MarkWendler/X2C_BLDC_Shield/README.md

# X2C_BLDC_Shield
BLDC motor driver expansion board for X2C+ development board
