MarkWendler/X2C_BLDC_Shield/BLDC_Schematics.pdf

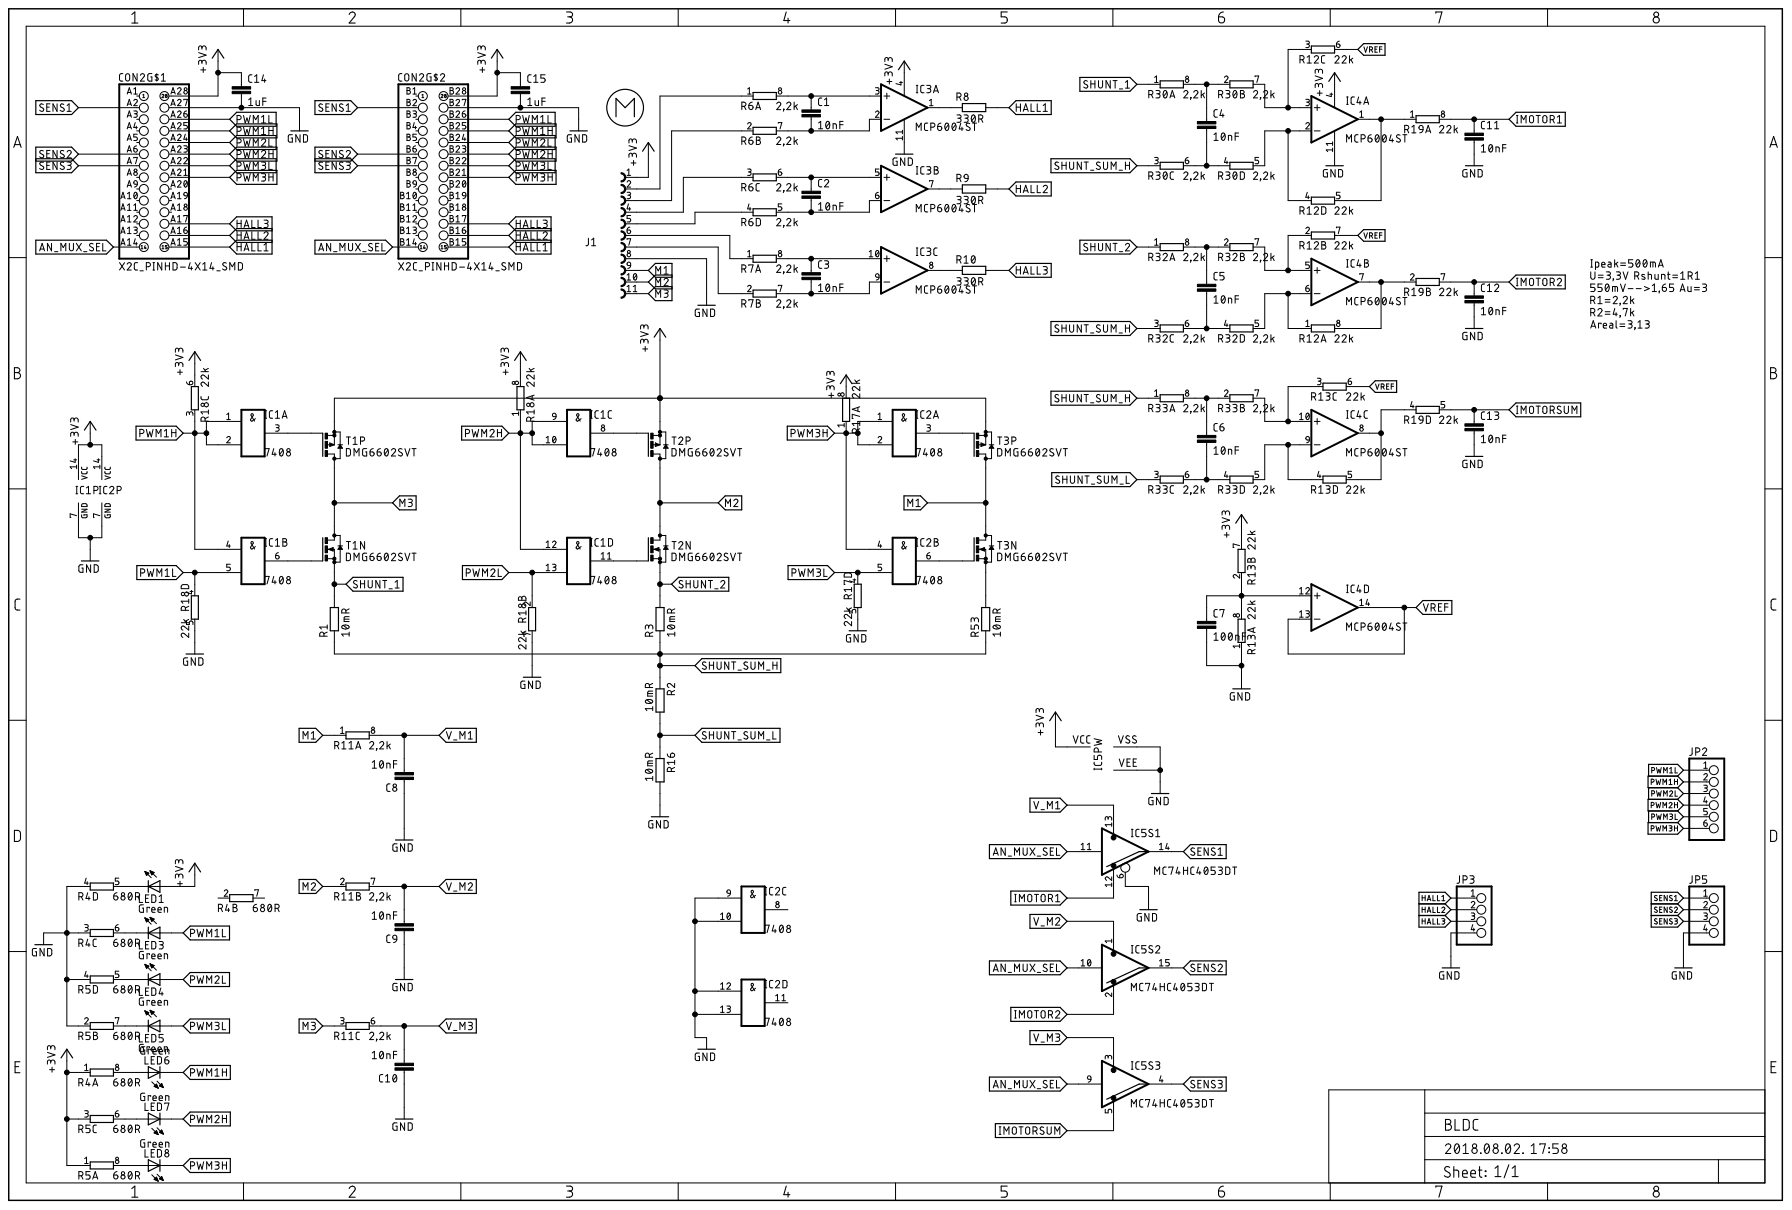
[picture p1: page 1]
