MarkWendler/X2C_BLDC_Shield/BLDC.brd

## EAGLE design BLDC.brd (2018-08-02)

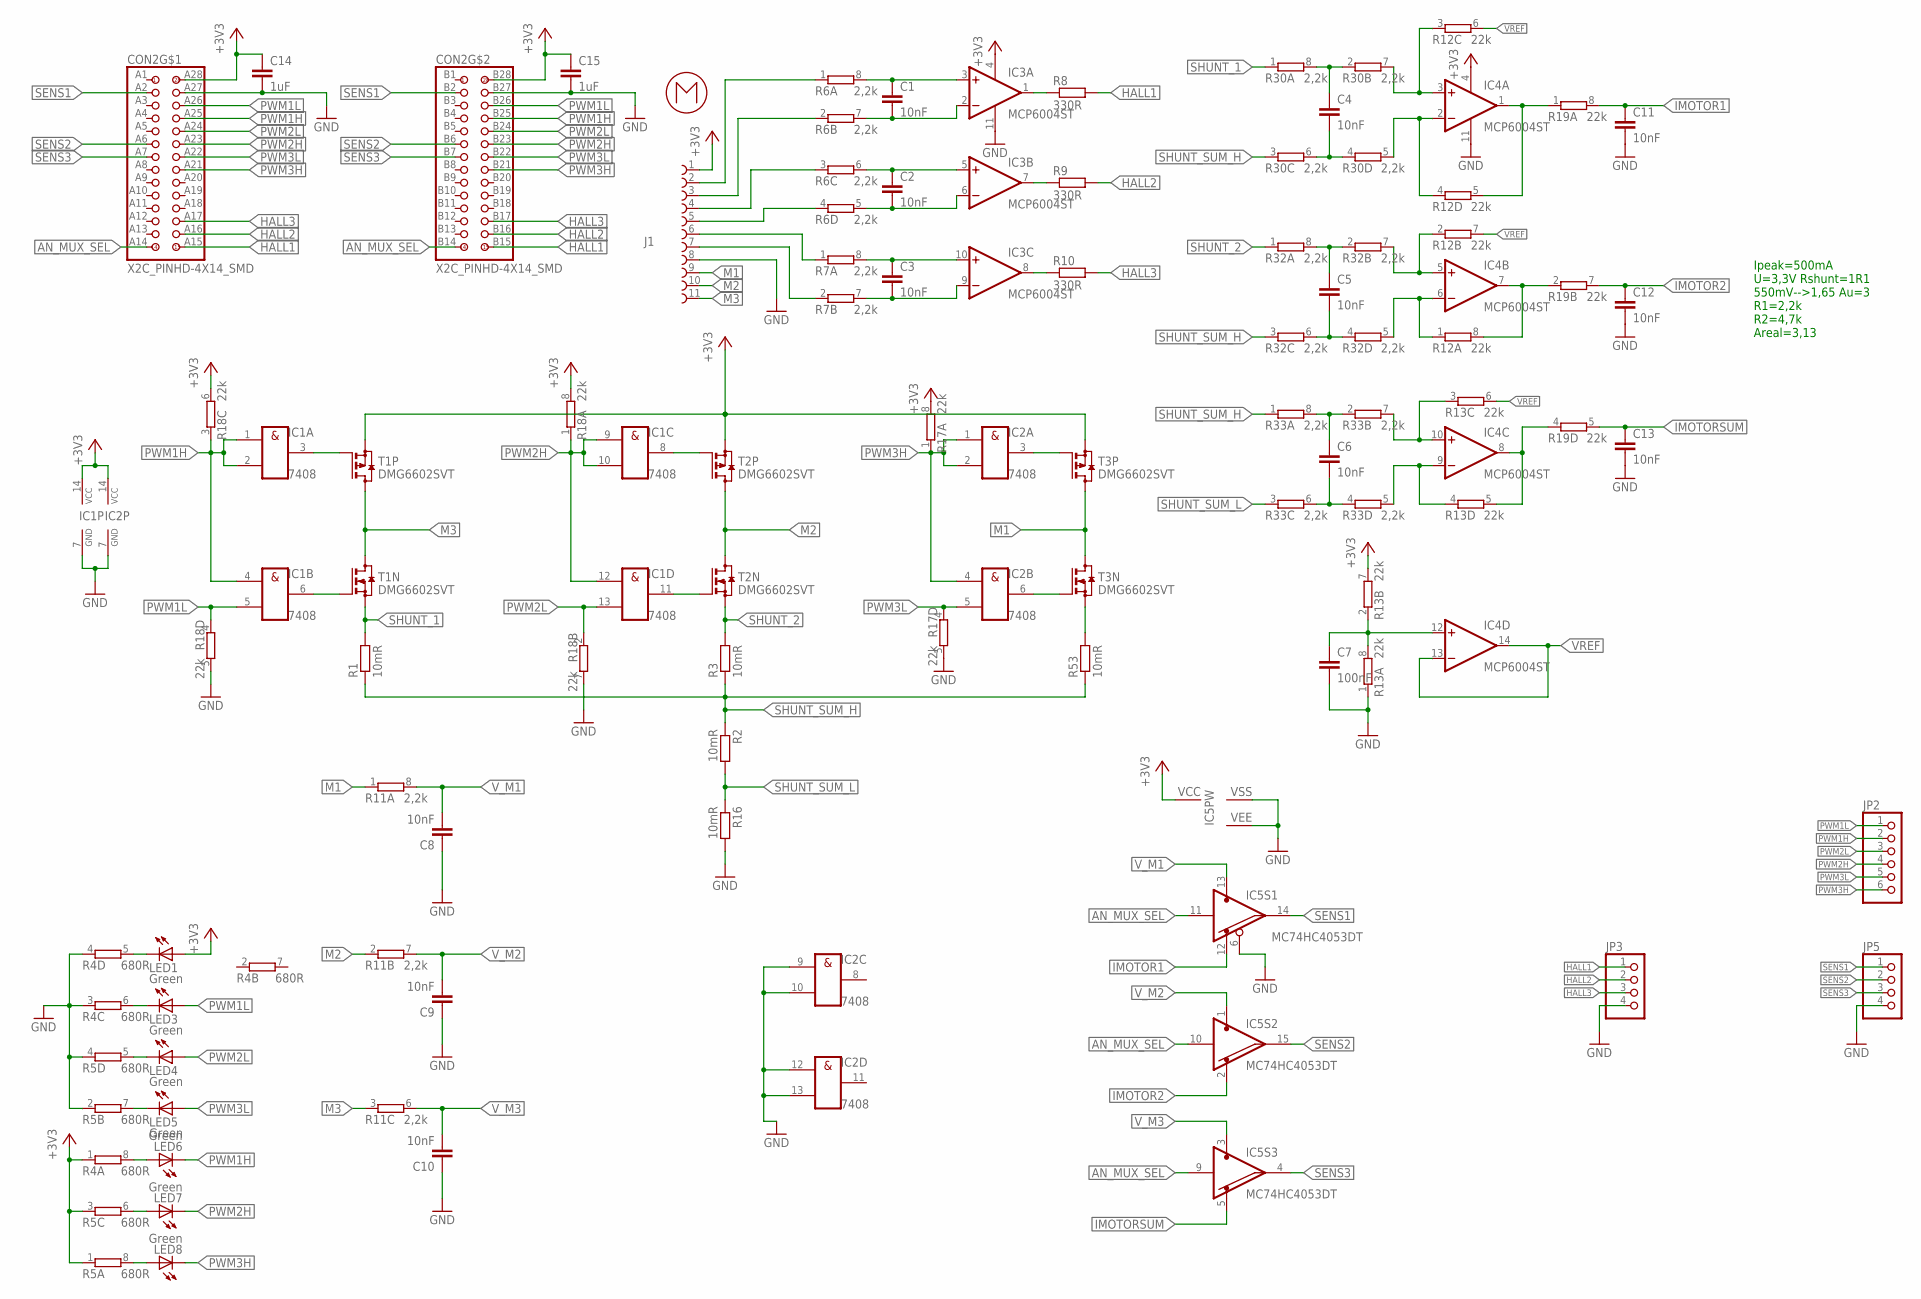
[picture p2: schematic BLDC.sch]

Parts:
C1, C2, C3, C4, C5, C6, C8, C9, C10, C11, C12, C13: 10nF; C0603K
C7: 100nF; C0603K
C14, C15: 1uF; C0603K
CON2: X2C_PINHD-4X14_SMD; X2C_4X14_SMD
IC1, IC2: 7408; TSSOP14
IC3, IC4: MCP6004ST; TSSOP14
IC5: MC74HC4053DT; TSSOP16
J1: 68611114122
JP2: PINHD-1X6; 1X06
JP3, JP5: PINHD-1X4; 1X04
LED1, LED3, LED4, LED5, LED6, LED7, LED8: Green; CHIPLED_0805
R1, R2, R3, R16, R53: 10mR; R1206
R4, R5: 680R; EXBV8V_A
R6, R7, R11, R30, R32, R33: 2,2k; EXBV8V_A
R8, R9, R10: 330R; R0603
R12, R13, R17, R18, R19: 22k; EXBV8V_A
T1, T2, T3: DMG6602SVT; TSOT23-6
U$2: BLDC_MOTOR

Connections:
+3V3: C14.1, C15.1, CON2.A28, CON2.B28 (A28), IC1.14 (VCC), IC2.14 (VCC), IC3.4 (V+), IC4.4 (V+), IC5.16 (VCC), J1.1, LED1.A, R4.1, R5.1, R5.3 (1), R13.7 (2), R17.8 (2), R18.6 (2), R18.8 (2), T1.2 (S), T2.2 (S), T3.2 (S)
AN_MUX_SEL: CON2.A14, CON2.B14 (A14), IC5.9 (I), IC5.10 (I), IC5.11 (I)
GND: C7.2, C8.1, C9.1, C10.1, C11.2, C12.2, C13.2, C14.2, C15.2, CON2.A27, CON2.B27 (A27), IC1.7 (GND), IC2.7 (GND), IC2.9 (I0), IC2.10 (I1), IC2.12 (I0), IC2.13 (I1), IC3.11 (V-), IC4.11 (V-), IC5.6, IC5.7 (VEE), IC5.8 (GND), J1.8, JP3.4, JP5.4, R4.3 (1), R4.4 (1), R5.2 (1), R5.4 (1), R13.1, R16.2, R17.5 (2), R18.5 (2), R18.7 (2)
HALL1: CON2.A15, CON2.B15 (A15), JP3.1, R8.2
HALL2: CON2.A16, CON2.B16 (A16), JP3.2, R9.2
HALL3: CON2.A17, CON2.B17 (A17), JP3.3, R10.2
IMOTOR1: C11.1, IC5.12 (O2), R19.8 (2)
IMOTOR2: C12.1, IC5.2 (O2), R19.7 (2)
IMOTORSUM: C13.1, IC5.5 (O2), R19.5 (2)
M1: J1.9, R11.1, T3.4 (D), T3.6 (D)
M2: J1.10, R11.2 (1), T2.4 (D), T2.6 (D)
M3: J1.11, R11.3 (1), T1.4 (D), T1.6 (D)
unnamed: IC1.3 (O), T1.3 (G)
unnamed: IC1.6 (O), T1.1 (G)
unnamed: IC1.8 (O), T2.3 (G)
unnamed: IC1.11 (O), T2.1 (G)
unnamed: IC2.3 (O), T3.3 (G)
unnamed: IC2.6 (O), T3.1 (G)
unnamed: C1.1, IC3.3 (+IN), R6.8 (2)
unnamed: C1.2, IC3.2 (-IN), R6.7 (2)
unnamed: IC4.8 (OUT), R13.5 (2), R19.4 (1)
unnamed: C5.1, R32.2 (1), R32.8 (2)
unnamed: C4.1, R30.2 (1), R30.8 (2)
unnamed: C4.2, R30.4 (1), R30.6 (2)
unnamed: IC4.3 (+IN), R12.3 (1), R30.7 (2)
unnamed: IC4.2 (-IN), R12.4 (1), R30.5 (2)
unnamed: C5.2, R32.4 (1), R32.6 (2)
unnamed: IC4.6 (-IN), R12.1, R32.5 (2)
unnamed: IC4.5 (+IN), R12.2 (1), R32.7 (2)
unnamed: C7.1, IC4.12 (+IN), R13.2 (1), R13.8 (2)
unnamed: IC3.8 (OUT), R10.1
unnamed: LED8.A, R5.8 (2)
unnamed: C6.1, R33.2 (1), R33.8 (2)
unnamed: IC4.10 (+IN), R13.3 (1), R33.7 (2)
unnamed: IC4.9 (-IN), R13.4 (1), R33.5 (2)
unnamed: C6.2, R33.4 (1), R33.6 (2)
unnamed: LED7.A, R5.6 (2)
unnamed: LED5.C, R5.7 (2)
unnamed: IC4.7 (OUT), R12.8 (2), R19.2 (1)
unnamed: C2.1, IC3.5 (+IN), R6.6 (2)
unnamed: LED4.C, R5.5 (2)
unnamed: LED6.A, R4.8 (2)
unnamed: LED3.C, R4.6 (2)
unnamed: LED1.C, R4.5 (2)
unnamed: IC4.1 (OUT), R12.5 (2), R19.1
unnamed: C2.2, IC3.6 (-IN), R6.5 (2)
unnamed: C3.2, IC3.9 (-IN), R7.7 (2)
unnamed: R53.2, T3.5 (S)
unnamed: C3.1, IC3.10 (+IN), R7.8 (2)
unnamed: J1.2, R6.1
unnamed: J1.3, R6.2 (1)
unnamed: J1.4, R6.3 (1)
unnamed: J1.5, R6.4 (1)
unnamed: J1.6, R7.1
unnamed: J1.7, R7.2 (1)
unnamed: IC3.1 (OUT), R8.1
unnamed: IC3.7 (OUT), R9.1
PWM1H: CON2.A25, CON2.B25 (A25), IC1.1 (I0), IC1.2 (I1), IC1.4 (I0), JP2.2, LED6.C, R18.3 (1)
PWM1L: CON2.A26, CON2.B26 (A26), IC1.5 (I1), JP2.1, LED3.A, R18.4 (1)
PWM2H: CON2.A23, CON2.B23 (A23), IC1.9 (I0), IC1.10 (I1), IC1.12 (I0), JP2.4, LED7.C, R18.1
PWM2L: CON2.A24, CON2.B24 (A24), IC1.13 (I1), JP2.3, LED4.A, R18.2 (1)
PWM3H: CON2.A21, CON2.B21 (A21), IC2.1 (I0), IC2.2 (I1), IC2.4 (I0), JP2.6, LED8.C, R17.1
PWM3L: CON2.A22, CON2.B22 (A22), IC2.5 (I1), JP2.5, LED5.A, R17.4 (1)
SENS1: CON2.A2, CON2.B2 (A2), IC5.14 (O), JP5.1
SENS2: CON2.A6, CON2.B6 (A6), IC5.15 (O), JP5.2
SENS3: CON2.A7, CON2.B7 (A7), IC5.4 (O), JP5.3
SHUNT_1: R1.2, R30.1, T1.5 (S)
SHUNT_2: R3.2, R32.1, T2.5 (S)
SHUNT_SUM_H: R1.1, R2.1, R3.1, R30.3 (1), R32.3 (1), R33.1, R53.1
SHUNT_SUM_L: R2.2, R16.1, R33.3 (1)
VREF: IC4.13 (-IN), IC4.14 (OUT), R12.6 (2), R12.7 (2), R13.6 (2)
V_M1: C8.2, IC5.13 (O1), R11.8 (2)
V_M2: C9.2, IC5.1 (O1), R11.7 (2)
V_M3: C10.2, IC5.3 (O1), R11.6 (2)

Notes on the sheet:
Ipeak=500mA U=3,3V Rshunt=1R1 550mV-->1,65 Au=3 R1=2,2k R2=4,7k Areal=3,13

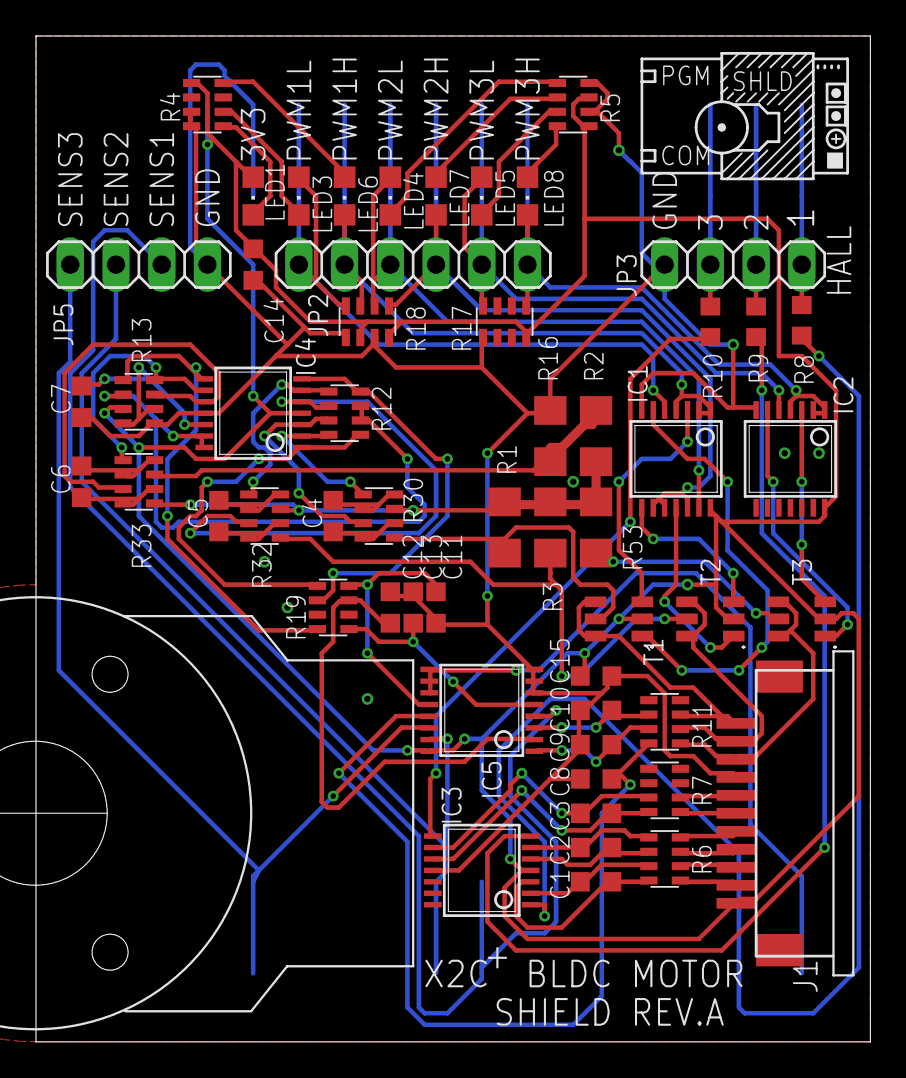
[picture p3: board BLDC.brd from above]

Board: 2 copper layers, 46.4 x 55.9 mm, 57 parts (1 on the bottom side), 74 nets.
