MarkWendler/X2C_BLDC_Shield/(commit log)

2018-08-02 BLDC REVA
    [BLDC.brd, BLDC.sch]
2018-08-02 BLDC spinning project dsPIC
    Full speed BLDC spinning
2020-02-20 Updated peripheral drivers for newest MCC. Also updated commutation logic.
2020-02-21 Commutation sequence fixed, high side driving inverted (PNP)
    [main.c]
2020-02-21 PWM freq increased, ADC scaling and duty cycle is changed to reach max BLDC performance
2020-02-21 ADC interrupt added for POT measurement and duty cycle update
2025-11-14 Add schematics pdf format
2025-11-14 Increased PWM freq and added Timer2 for speed
