MarkWendler/X2C_BLDC_Shield/(notices)

Notices in the files:
parts and their libraries:
Wurth_Elektronik_Electromechanic_FPC_Con: Copyright: Würth Elektronik
